legokor/INDACT_Hardware/RC_SHIELD/INDACT_baseboard.xlsx

Source: | C:\Users\Andi\Desktop\Andi\SULI\BME\Legokor\INDACT\INDACT_bb\repo\INDACT_Hardware\RC_SHIELD\INDACT_baseboard.kicad_sch
Date: | 2023-10-18 21:43
Tool: | Eeschema 7.0.7
Generator: | C:\Program Files\KiCad\7.0\bin\scripting\plugins/bom_csv_grouped_by_value.py
Component Count: | 135
Collated Components:
Item | Qty | Reference(s) | Value | DNP | Price | Link
1 | 1 | A1 | NUCLEO-F746ZG |  | None
2 | 2 | C1, C12 | 1u | 32.13 | 64.26 | https://www.hestore.hu/prod_10036059.html
3 | 2 | C2, C3 | 1.5n | 4.17 | 8.34 | https://www.hestore.hu/prod_10001406.html
4 | 5 | C4, C5, C10, C11, C14 | 100n | 29.93 | 149.65 | https://www.hestore.hu/prod_10039650.html
5 | 3 | C6, C7, C8 | 1000u | 380 | 1140 | https://www.hestore.hu/prod_10028496.html
6 | 1 | C9 | 10n | 30.04 | 30.04 | https://www.hestore.hu/prod_10024356.html
7 | 1 | C13 | 4u7 | 31.37 | 31.37 | https://www.hestore.hu/prod_10037167.html
8 | 2 | C15, C16 | 11p |  | 0 | tesó ez mi
9 | 1 | D1 | WIFI-OP | 50 | 50 | https://www.hestore.hu/prod_10025836.html
10 | 1 | D2 | 3V3_STATUS | 50 | 50 | más szín?
11 | 1 | D3 | 5V_STATUS | 50 | 50 | más szín?
12 | 1 | D4 | 24V_STATUS | 50 | 50 | más szín?
13 | 1 | J1 | P5a | 654 | 654 | https://www.hestore.hu/prod_10026484.html
14 | 1 | J2 | P4a | 387 | 387 | https://www.hestore.hu/prod_10026483.html
15 | 1 | J3 | FAN |  | 0 | sima pin, van
16 | 1 | J4 | I2C_TEMP |  | 0 | sima pin, van
17 | 1 | J5 | GPIO1 |  | 0 | sima pin, van
18 | 1 | J6 | ESTOP |  | 0 | sima pin, van
19 | 1 | J7 | DOOR_SWITCH |  | 0 | sima pin, van
20 | 1 | J8 | GPIO2 |  | 0 | sima pin, van
21 | 1 | J9 | SPI |  | 0 | sima pin, van
22 | 1 | J10 | POWER_SUPPLY | 202 | 202 | https://www.hestore.hu/prod_10042566.html
23 | 1 | J11 | R_MOT_DRV | 202 | 202 | https://www.hestore.hu/prod_10042566.html
24 | 1 | J12 | TH_MOT_DRV | 202 | 202 | https://www.hestore.hu/prod_10042566.html
25 | 1 | J13 | Z_MOT_DRV | 202 | 202 | https://www.hestore.hu/prod_10042566.html
26 | 1 | J14 | ALF_MOT_DRV | 202 | 202 | https://www.hestore.hu/prod_10042566.html
27 | 1 | J17 | PHI_MOT_DRV | 202 | 202 | https://www.hestore.hu/prod_10042566.html
28 | 1 | J25 | BET_MOT_DRV | 202 | 202 | https://www.hestore.hu/prod_10042566.html
29 | 1 | J26 | SWD |  | 0
30 | 1 | J27 | P3a | 181 | 181 | https://www.hestore.hu/prod_10031174.html
31 | 2 | Q1, Q2 | BSS123 | 43.82 | 87.64 | https://www.hestore.hu/prod_10021019.html
32 | 2 | R1, R11 | 1k | 28.47 | 56.94 | https://www.hestore.hu/prod_10023881.html
33 | 1 | R2 | 150R | 1.18 | 1.18 | https://www.hestore.hu/prod_10023929.html
34 | 4 | R3, R4, R6, R7 | 560R | 3.83 | 15.32 | https://www.hestore.hu/prod_10023915.html
35 | 1 | R5 | 1K? | 28.47 | 28.47 | https://www.hestore.hu/prod_10023881.html
36 | 2 | R8, R10 | 120R | 29.1 | 58.2 | https://www.hestore.hu/prod_10023914.html
37 | 1 | R9 | 4K7 | 3.9 | 3.9 | https://www.hestore.hu/prod_10023911.html
38 | 1 | R12 | 5k1 | 1.18 | 1.18 | https://www.hestore.hu/prod_10036539.html
39 | 28 | R13, R14, R15, R16, R20, R21, R22, R23, R24, R25, R26, R27, R28, R29, R30, R31, R32, R33, R36, R37, R38, R39, R40, R41, R42, R43, R44, R45 | 1K2 | 1.18 | 33.04 | https://www.hestore.hu/prod_10023920.html
40 | 3 | R17, R18, R19 | 100R | 28.56 | 85.68 | https://www.hestore.hu/prod_10023885.html
41 | 1 | R34 | 20k | 28.45 | 28.45 | https://www.hestore.hu/prod_10028622.html
42 | 1 | R35 | 200k | 29.58 | 29.58 | https://www.hestore.hu/prod_10001160.html
43 | 1 | RV1 | DISP_CONTRAST | 121 | 121 | https://www.hestore.hu/prod_10043614.html
44 | 1 | SW1 | SW_Push | 203 | 203 | https://www.hestore.hu/prod_10027967.html
45 | 1 | TP1 | TP_24V |  | 0 | tesztpont
46 | 1 | TP2 | TP_5V |  | 0 | tesztpont
47 | 1 | TP3 | TP_COM24 |  | 0 | tesztpont
48 | 1 | TP4 | TP_COM5 |  | 0 | tesztpont
49 | 1 | TP5 | TP_3V3 |  | 0 | tesztpont
50 | 1 | TP6 | TP_ESP01_RST |  | 0 | tesztpont
51 | 1 | TP7 | TP_ESP01_CHPD |  | 0 | tesztpont
52 | 1 | TP8 | TP_LCD_ENA |  | 0 | tesztpont
53 | 1 | TP9 | TP_LCD_Contrast |  | 0 | tesztpont
54 | 1 | TP10 | TP_SPI_NSS |  | 0 | tesztpont
55 | 1 | U1 | ESP8266-01/ESP-01 |  | 0 | van
56 | 1 | U2 | SN75LBC179AD | 1312 | 1312 | https://www.tme.eu/hu/en/details/sn75lbc179ad/rs232-422-485-interfaces-integr-circ/texas-instruments/
57 | 1 | U3 | LCD-016N002L |  | 0
58 | 31 | U4, U5, U6, U7, U8, U9, U10, U11, U12, U13, U14, U15, U16, U17, U18, U19, U20, U21, U22, U23, U24, U26, U27, U28, U29, U30, U31, U32, U33, U34, U35 | SFH6345 | 276 | 8556 | https://www.hestore.hu/prod_10034079.html
59 | 1 | U25 | STM32F030K6Tx | 566 | 566 | https://www.hestore.hu/prod_10044309.html
60 | 1 | VR1 | LM3940IMP-3.3/NOPB | 737 | 737 | https://www.hestore.hu/prod_10028511.html
61 | 1 | Y1 | 8MHz | 112 | 112 | https://www.hestore.hu/prod_10030976.html
 |  |  |  |  | 16296.24
 |  |  |  | +áfa | 20696.2248
