legokor/INDACT_Hardware/RC_SHIELD/INDACT_baseboard_pcb.pdf

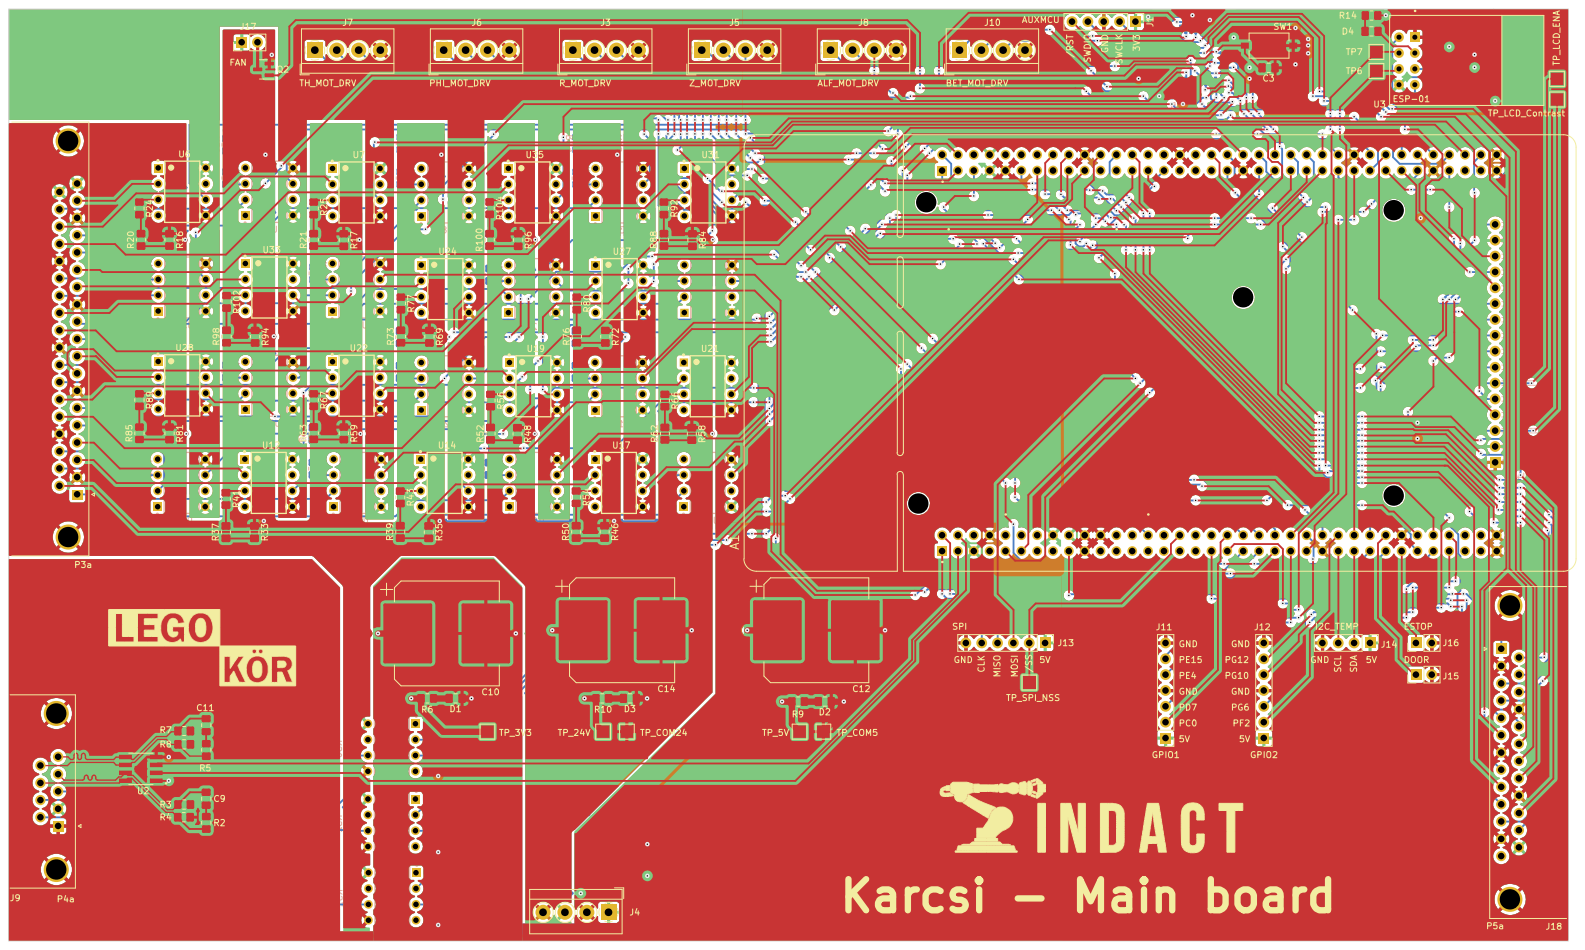
[picture p1: page 1]
