legokor/INDACT_Hardware/RC_SHIELD/bb_mcu2.kicad_sch

## KiCad design RC_SHIELD/bb_mcu2.kicad_sch (2024-06-19)

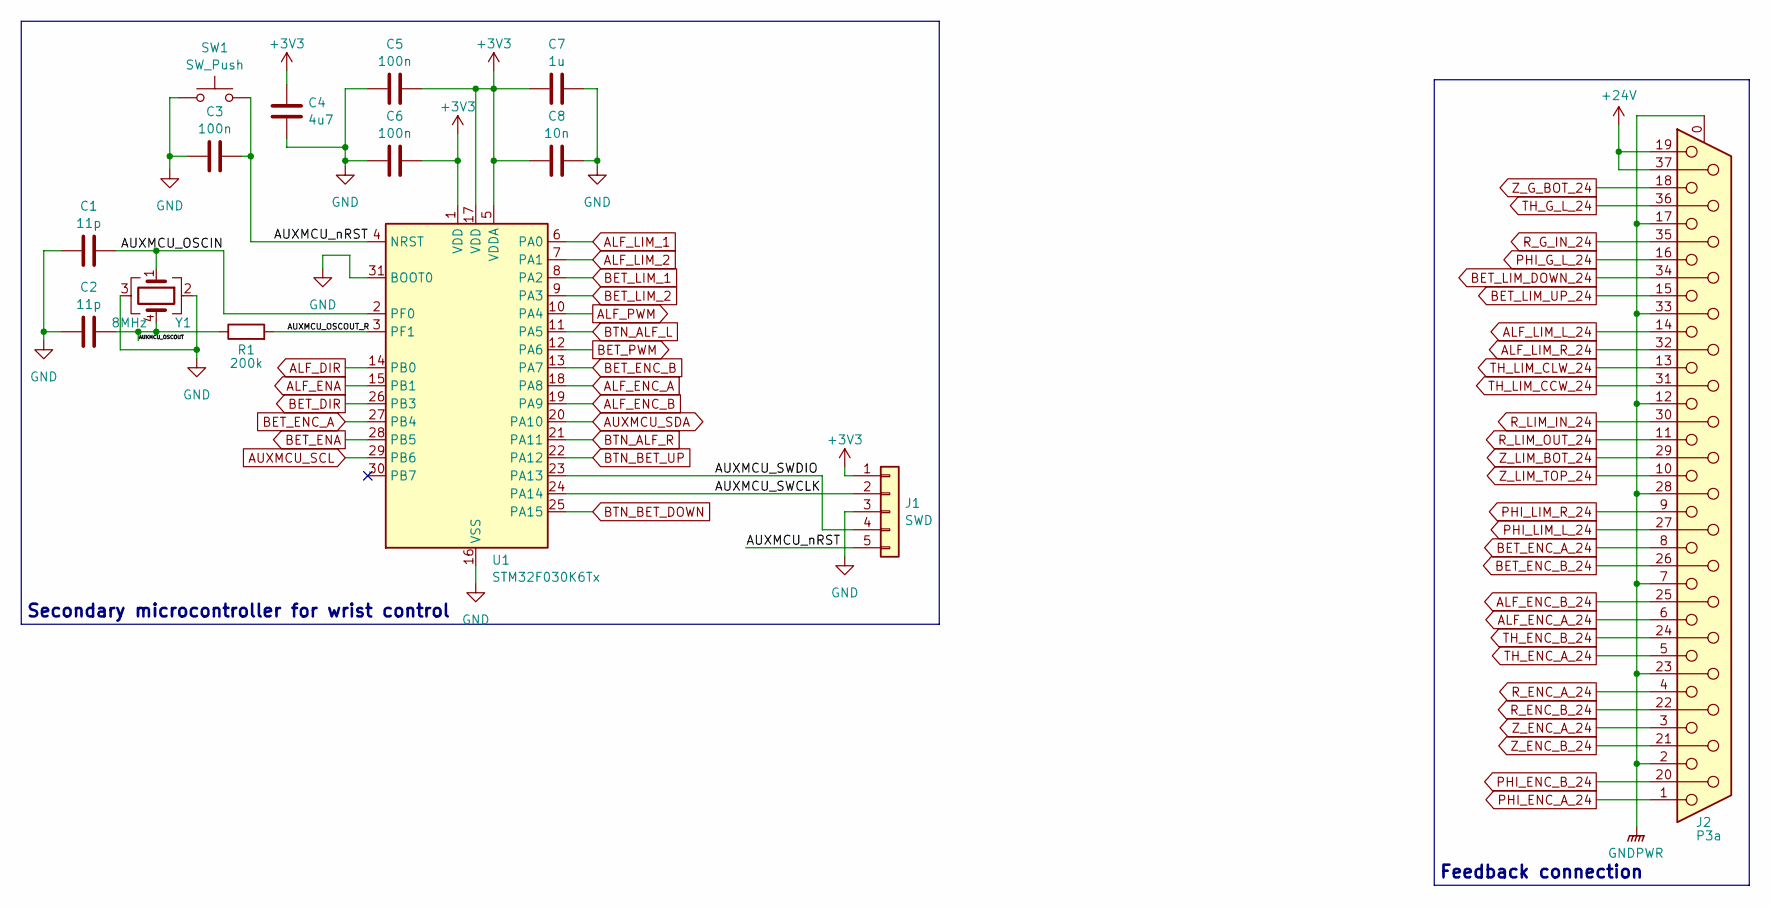
[picture p9: schematic bb_mcu2.kicad_sch]

Parts:
C1, C2: 11p; C_0805_2012Metric_Pad1.18x1.45mm_HandSolder
C3, C5, C6: 100n; C_0805_2012Metric_Pad1.18x1.45mm_HandSolder
C4: 4u7; C_0805_2012Metric_Pad1.18x1.45mm_HandSolder
C7: 1u; C_0805_2012Metric_Pad1.18x1.45mm_HandSolder
C8: 10n; C_0805_2012Metric_Pad1.18x1.45mm_HandSolder
J1: SWD; PinHeader_1x05_P2.54mm_Vertical
J2: P3a; DSUB-37_Female_Horizontal_P2.77x2.84mm_EdgePinOffset7.70mm_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
R1: 200k; R_0805_2012Metric_Pad1.20x1.40mm_HandSolder
SW1: SW_Push; SW_Tactile_SPST_NO_Straight_CK_PTS636Sx25SMTRLFS
U1: STM32F030K6Tx; LQFP-32_7x7mm_P0.8mm
Y1: 8MHz; Crystal_SMD_3225-4Pin_3.2x2.5mm_HandSoldering

Connections:
+3V3: C4.1, C5.2, C6.2, C7.1, C8.1, J1.1, U1.1 (VDD), U1.5 (VDDA), U1.17 (VDD)
+24V: J2.19, J2.37
ALF_DIR: U1.14 (PB0)
ALF_ENA: U1.15 (PB1)
ALF_ENC_A: U1.18 (PA8)
ALF_ENC_A_24: J2.6
ALF_ENC_B: U1.19 (PA9)
ALF_ENC_B_24: J2.25
ALF_LIM_1: U1.6 (PA0)
ALF_LIM_2: U1.7 (PA1)
ALF_LIM_L_24: J2.14
ALF_LIM_R_24: J2.32
ALF_PWM: U1.10 (PA4)
AUXMCU_OSCIN: C1.2, U1.2 (PF0), Y1.1
AUXMCU_OSCOUT: C2.2, R1.1, Y1.4
AUXMCU_OSCOUT_R: R1.2, U1.3 (PF1)
AUXMCU_SCL: U1.29 (PB6)
AUXMCU_SDA: U1.20 (PA10)
AUXMCU_SWCLK: J1.2, U1.24 (PA14)
AUXMCU_SWDIO: J1.4, U1.23 (PA13)
AUXMCU_nRST: C3.2, J1.5, SW1.2, U1.4 (NRST)
BET_DIR: U1.26 (PB3)
BET_ENA: U1.28 (PB5)
BET_ENC_A: U1.27 (PB4)
BET_ENC_A_24: J2.8
BET_ENC_B: U1.13 (PA7)
BET_ENC_B_24: J2.26
BET_LIM_1: U1.8 (PA2)
BET_LIM_2: U1.9 (PA3)
BET_LIM_DOWN_24: J2.34
BET_LIM_UP_24: J2.15
BET_PWM: U1.12 (PA6)
BTN_ALF_L: U1.11 (PA5)
BTN_ALF_R: U1.21 (PA11)
BTN_BET_DOWN: U1.25 (PA15)
BTN_BET_UP: U1.22 (PA12)
GND: C1.1, C2.1, C3.1, C4.2, C5.1, C6.1, C7.2, C8.2, J1.3, SW1.1, U1.16 (VSS), U1.31 (BOOT0), U1.32 (VSS), Y1.2, Y1.3
GNDPWR: J2.0 (PAD), J2.2, J2.7, J2.12, J2.17, J2.23, J2.28, J2.33
PHI_ENC_A_24: J2.1
PHI_ENC_B_24: J2.20
PHI_G_L_24: J2.16
PHI_LIM_L_24: J2.27
PHI_LIM_R_24: J2.9
R_ENC_A_24: J2.4
R_ENC_B_24: J2.22
R_G_IN_24: J2.35
R_LIM_IN_24: J2.30
R_LIM_OUT_24: J2.11
TH_ENC_A_24: J2.5
TH_ENC_B_24: J2.24
TH_G_L_24: J2.36
TH_LIM_CCW_24: J2.31
TH_LIM_CLW_24: J2.13
Z_ENC_A_24: J2.3
Z_ENC_B_24: J2.21
Z_G_BOT_24: J2.18
Z_LIM_BOT_24: J2.29
Z_LIM_TOP_24: J2.10

Notes on the sheet:
Secondary microcontroller for wrist control
Feedback connection
