legokor/INDACT_Hardware/RC_SHIELD/bb_optocouplers2.kicad_sch

## KiCad design RC_SHIELD/bb_optocouplers2.kicad_sch (2024-06-19)

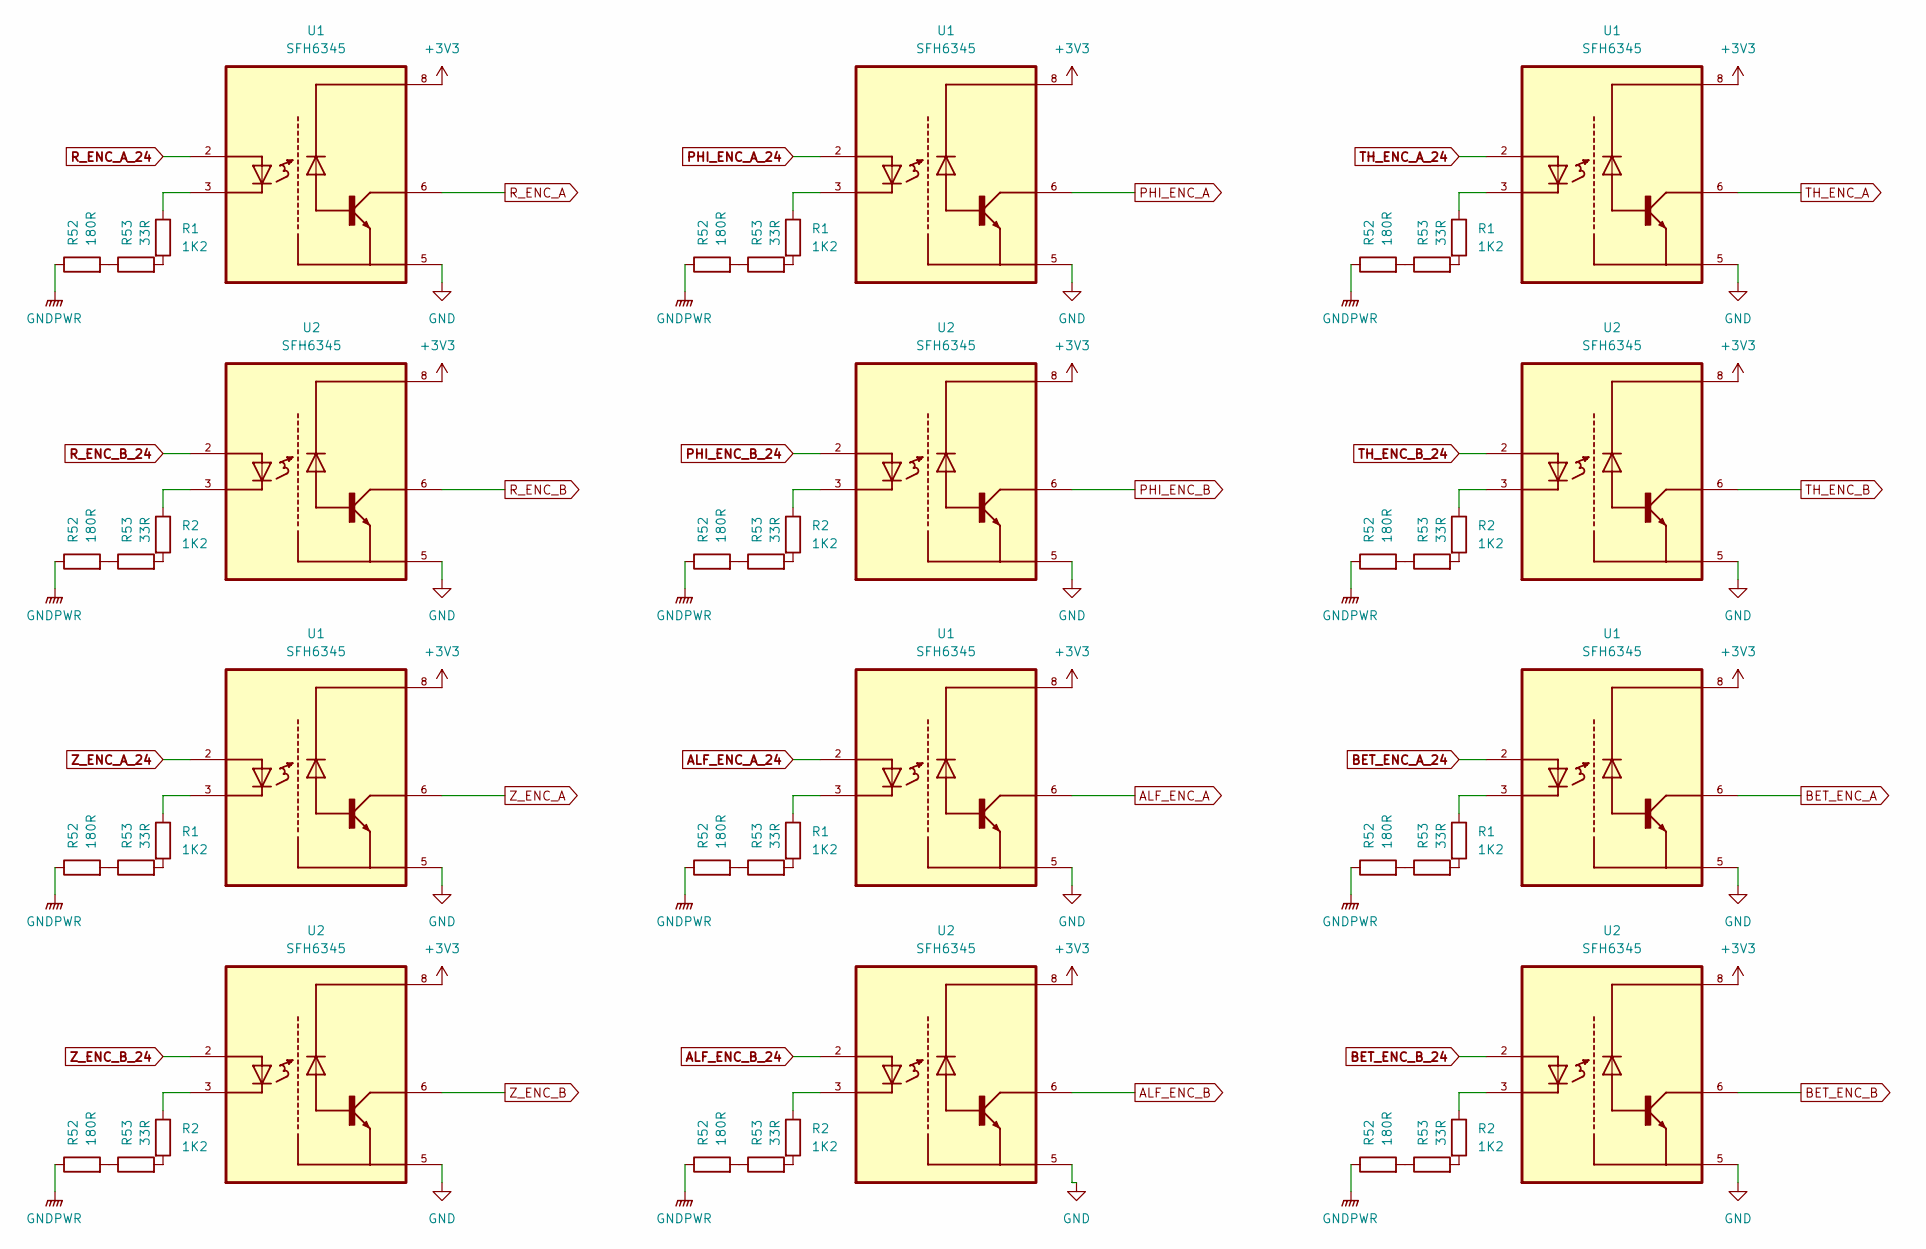
[picture p10: schematic bb_optocouplers2.kicad_sch]

Parts:
R1, R2: 1K2; R_0805_2012Metric_Pad1.20x1.40mm_HandSolder
R52: 180R; R_0805_2012Metric_Pad1.20x1.40mm_HandSolder
R53: 33R; R_0805_2012Metric_Pad1.20x1.40mm_HandSolder
U1, U2: SFH6345; DIP762W50P254L977H451Q8

Connections:
+3V3: U1.8, U2.8
ALF_ENC_A: U1.6
ALF_ENC_A_24: U1.2
ALF_ENC_B: U2.6
ALF_ENC_B_24: U2.2
BET_ENC_A: U1.6
BET_ENC_A_24: U1.2
BET_ENC_B: U2.6
BET_ENC_B_24: U2.2
GND: U1.5, U2.5
GNDPWR: R52.1
unnamed: R1.1, U1.3
unnamed: R1.2, R53.2
unnamed: R2.1, U2.3
unnamed: R2.2, R53.2
unnamed: R52.2, R53.1
PHI_ENC_A: U1.6
PHI_ENC_A_24: U1.2
PHI_ENC_B: U2.6
PHI_ENC_B_24: U2.2
R_ENC_A: U1.6
R_ENC_A_24: U1.2
R_ENC_B: U2.6
R_ENC_B_24: U2.2
TH_ENC_A: U1.6
TH_ENC_A_24: U1.2
TH_ENC_B: U2.6
TH_ENC_B_24: U2.2
Z_ENC_A: U1.6
Z_ENC_A_24: U1.2
Z_ENC_B: U2.6
Z_ENC_B_24: U2.2
