legokor/INDACT_Hardware/RC_SHIELD/bb_optocouplers.kicad_sch

## KiCad design RC_SHIELD/bb_optocouplers.kicad_sch (2024-06-19)

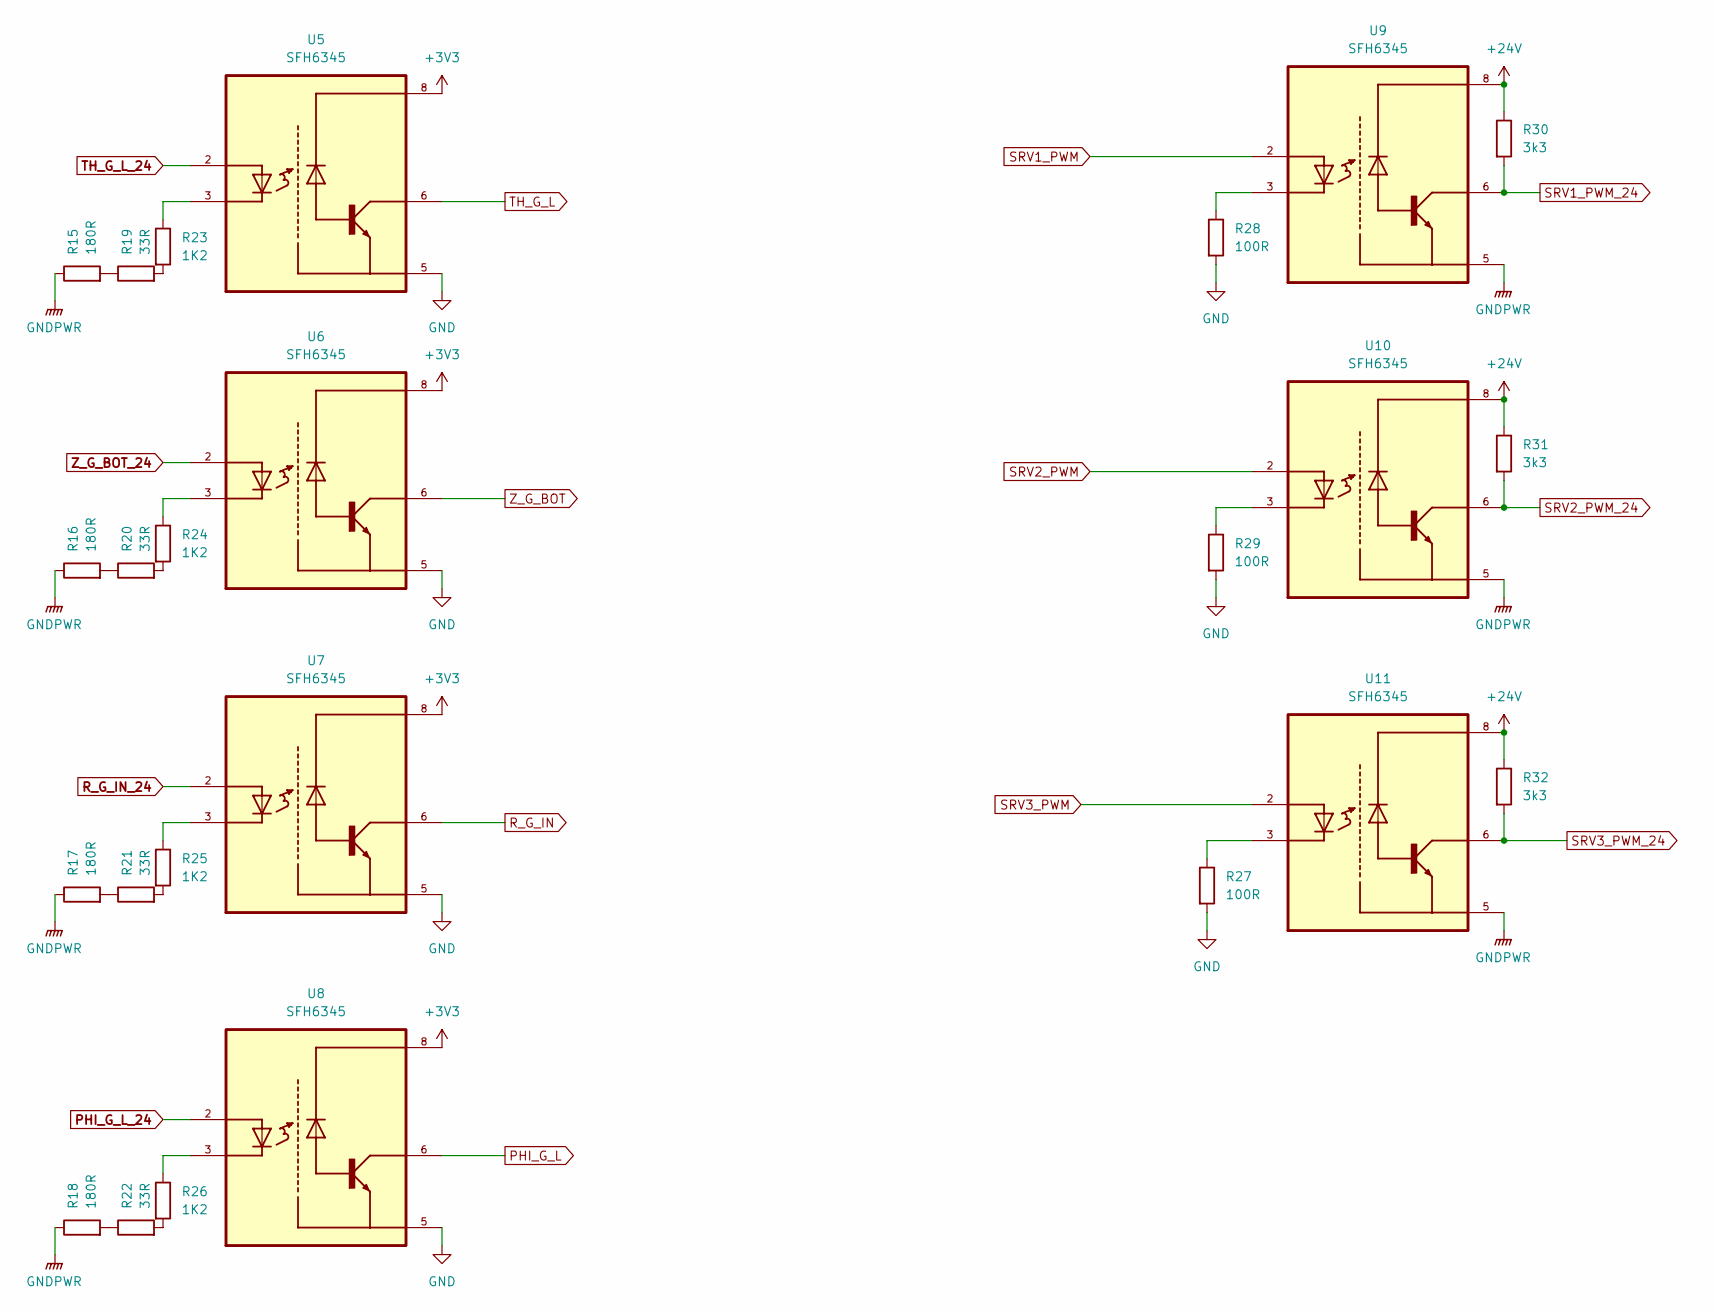
[picture p11: schematic bb_optocouplers.kicad_sch]

Parts:
R15, R16, R17, R18: 180R; R_0805_2012Metric_Pad1.20x1.40mm_HandSolder
R19, R20, R21, R22: 33R; R_0805_2012Metric_Pad1.20x1.40mm_HandSolder
R23, R24, R25, R26: 1K2; R_0805_2012Metric_Pad1.20x1.40mm_HandSolder
R27, R28, R29: 100R; R_0805_2012Metric_Pad1.20x1.40mm_HandSolder
R30, R31, R32: 3k3; R_0805_2012Metric_Pad1.20x1.40mm_HandSolder
U5, U6, U7, U8, U9, U10, U11: SFH6345; DIP762W50P254L977H451Q8

Connections:
+3V3: U5.8, U6.8, U7.8, U8.8
+24V: R30.1, R31.1, R32.1, U9.8, U10.8, U11.8
GND: R27.2, R28.2, R29.2, U5.5, U6.5, U7.5, U8.5
GNDPWR: R15.1, R16.1, R17.1, R18.1, U9.5, U10.5, U11.5
unnamed: R15.2, R19.1
unnamed: R16.2, R20.1
unnamed: R17.2, R21.1
unnamed: R18.2, R22.1
unnamed: R19.2, R23.2
unnamed: R20.2, R24.2
unnamed: R21.2, R25.2
unnamed: R22.2, R26.2
unnamed: R23.1, U5.3
unnamed: R24.1, U6.3
unnamed: R25.1, U7.3
unnamed: R26.1, U8.3
unnamed: R27.1, U11.3
unnamed: R28.1, U9.3
unnamed: R29.1, U10.3
PHI_G_L: U8.6
PHI_G_L_24: U8.2
R_G_IN: U7.6
R_G_IN_24: U7.2
SRV1_PWM: U9.2
SRV1_PWM_24: R30.2, U9.6
SRV2_PWM: U10.2
SRV2_PWM_24: R31.2, U10.6
SRV3_PWM: U11.2
SRV3_PWM_24: R32.2, U11.6
TH_G_L: U5.6
TH_G_L_24: U5.2
Z_G_BOT: U6.6
Z_G_BOT_24: U6.2
