legokor/INDACT_Hardware/RC_SHIELD/bb_periferia.kicad_sch

## KiCad design RC_SHIELD/bb_periferia.kicad_sch (2024-06-19)

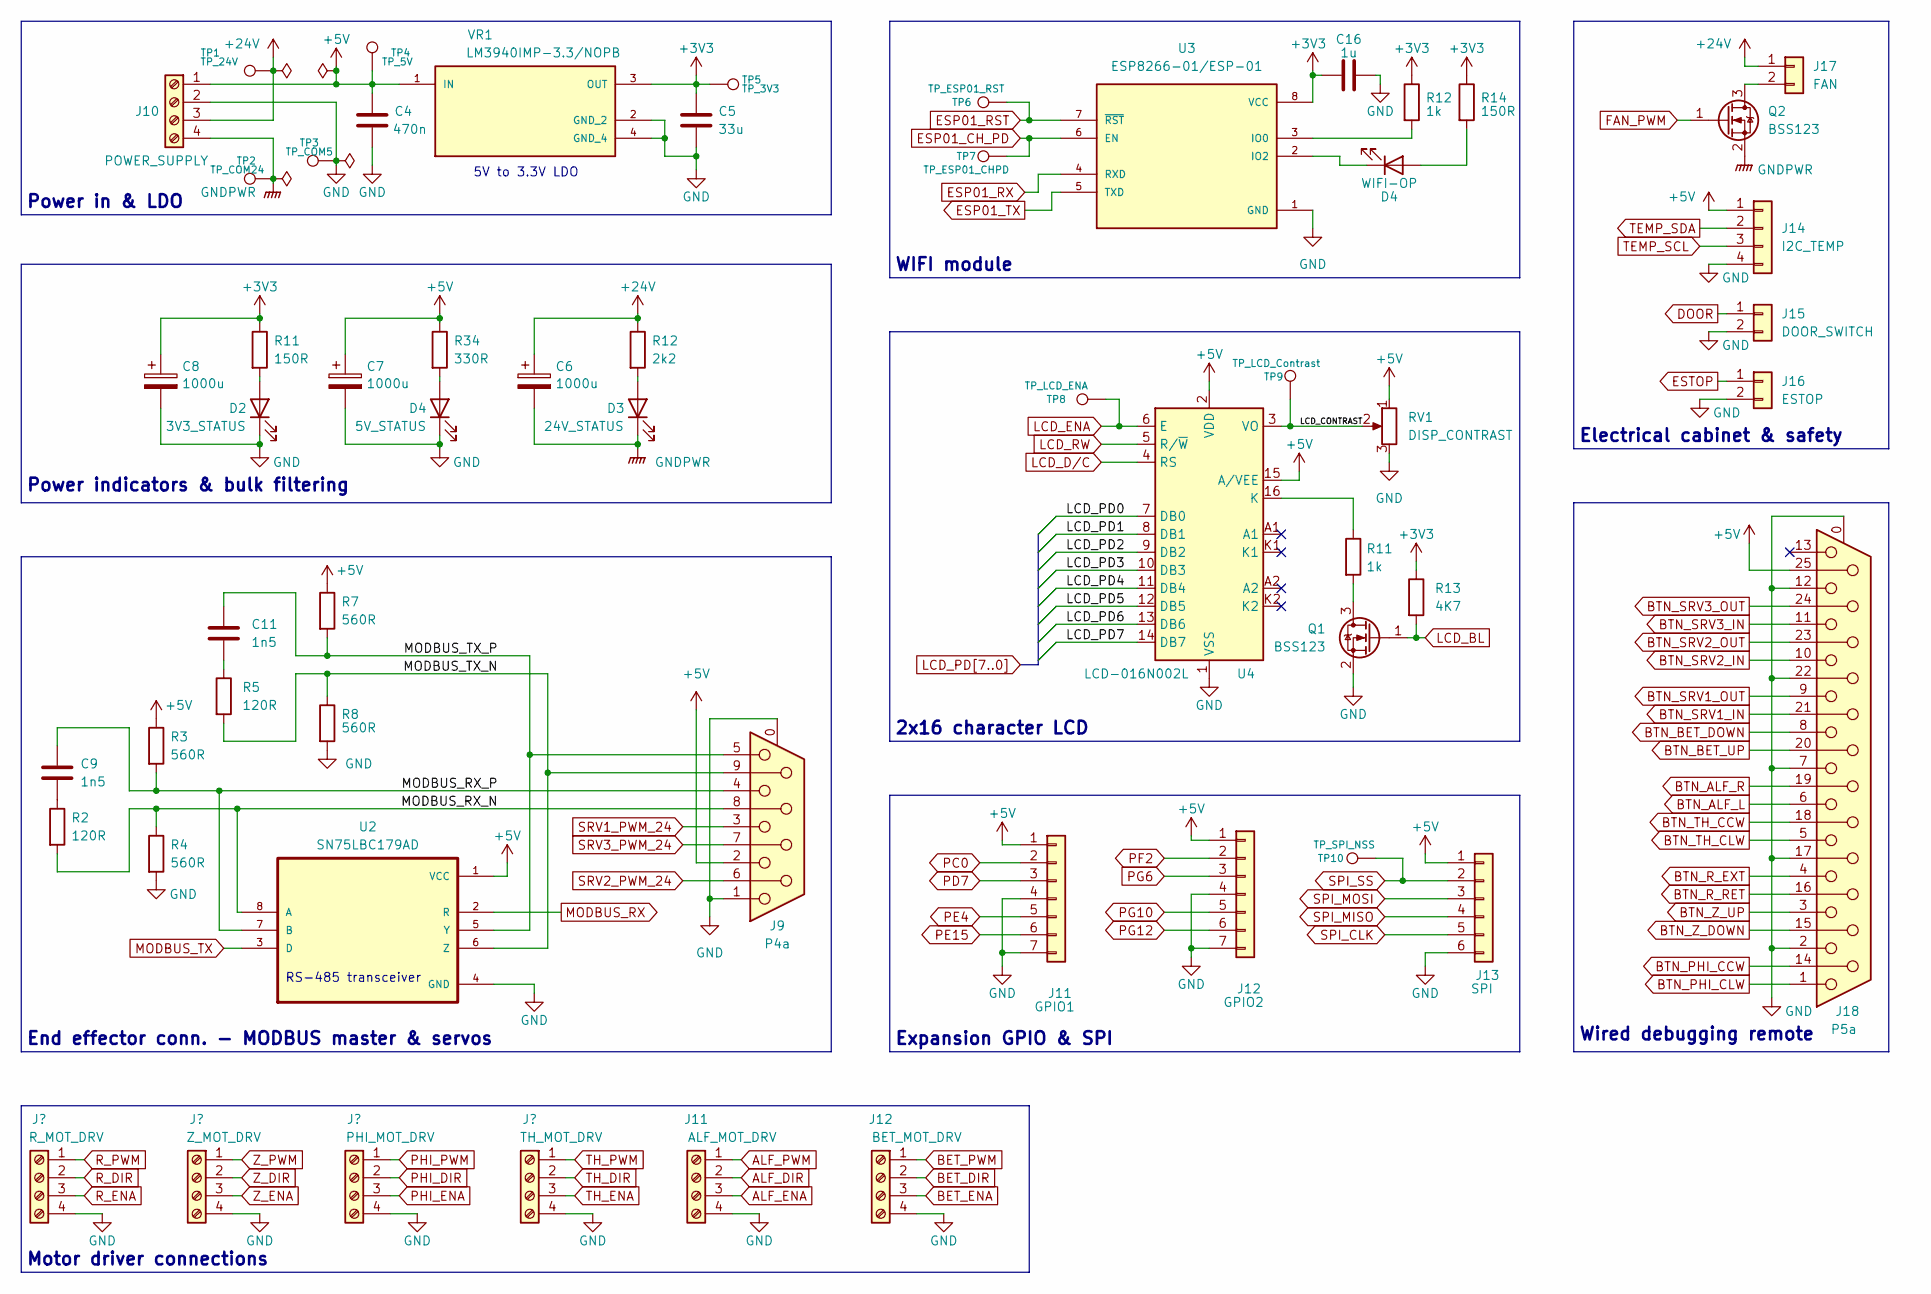
[picture p12: schematic bb_periferia.kicad_sch]

Parts:
C4: 470n; C_0805_2012Metric_Pad1.18x1.45mm_HandSolder
C5: 33u; C_0805_2012Metric_Pad1.18x1.45mm_HandSolder
C6, C7, C8: 1000u; CP_Elec_16x22
C9, C11: 1n5; C_0805_2012Metric_Pad1.18x1.45mm_HandSolder
C16: 1u; C_0805_2012Metric_Pad1.18x1.45mm_HandSolder
D2: 3V3_STATUS; LED_0805_2012Metric_Pad1.15x1.40mm_HandSolder
D3: 24V_STATUS; LED_0805_2012Metric_Pad1.15x1.40mm_HandSolder
D4: 5V_STATUS; LED_0805_2012Metric_Pad1.15x1.40mm_HandSolder
J3: R_MOT_DRV; TerminalBlock_4Ucon_1x04_P3.50mm_Horizontal
J5: Z_MOT_DRV; TerminalBlock_4Ucon_1x04_P3.50mm_Horizontal
J6: PHI_MOT_DRV; TerminalBlock_4Ucon_1x04_P3.50mm_Horizontal
J7: TH_MOT_DRV; TerminalBlock_4Ucon_1x04_P3.50mm_Horizontal
J9: P4a; DSUB-9_Female_Horizontal_P2.77x2.84mm_EdgePinOffset4.94mm_H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; PARTREV E
J10: POWER_SUPPLY; TerminalBlock_4Ucon_1x04_P3.50mm_Horizontal
J11: GPIO1; PinHeader_1x07_P2.54mm_Vertical
J12: BET_MOT_DRV; TerminalBlock_4Ucon_1x04_P3.50mm_Horizontal
J13: SPI; PinHeader_1x06_P2.54mm_Vertical
J14: I2C_TEMP; PinHeader_1x04_P2.54mm_Vertical
J15: DOOR_SWITCH; PinHeader_1x02_P2.54mm_Vertical
J16: ESTOP; PinHeader_1x02_P2.54mm_Vertical
J17: FAN; PinHeader_1x02_P2.54mm_Vertical
J18: P5a; DSUB-25_Female_Horizontal_P2.77x2.84mm_EdgePinOffset7.70mm_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
Q1, Q2: BSS123; SOT-23
R2, R5: 120R; R_0805_2012Metric_Pad1.20x1.40mm_HandSolder
R3, R4, R7, R8: 560R; R_0805_2012Metric_Pad1.20x1.40mm_HandSolder
R11: 1k; R_0805_2012Metric_Pad1.20x1.40mm_HandSolder
R12: 2k2; R_0805_2012Metric_Pad1.20x1.40mm_HandSolder
R13: 4K7; R_0805_2012Metric_Pad1.20x1.40mm_HandSolder
R14: 150R; R_0805_2012Metric_Pad1.20x1.40mm_HandSolder
R34: 330R; R_0805_2012Metric_Pad1.20x1.40mm_HandSolder
RV1: DISP_CONTRAST; Potentiometer_Vishay_TS53YJ_Vertical
TP1: TP_24V; TestPoint_Pad_2.0x2.0mm
TP2: TP_COM24; TestPoint_Pad_2.0x2.0mm
TP3: TP_COM5; TestPoint_Pad_2.0x2.0mm
TP4: TP_5V; TestPoint_Pad_2.0x2.0mm
TP5: TP_3V3; TestPoint_Pad_2.0x2.0mm
TP6: TP_ESP01_RST; TestPoint_Pad_2.0x2.0mm
TP7: TP_ESP01_CHPD; TestPoint_Pad_2.0x2.0mm
TP8: TP_LCD_ENA; TestPoint_Pad_2.0x2.0mm
TP9: TP_LCD_Contrast; TestPoint_Pad_2.0x2.0mm
TP10: TP_SPI_NSS; TestPoint_Pad_2.0x2.0mm
U2: SN75LBC179AD; SOIC127P599X175-8N
U3: ESP8266-01/ESP-01; XCVR_ESP8266-01_ESP-01; PARTREV V1.2
U4: LCD-016N002L; PinHeader_1x16_P2.54mm_Horizontal
VR1: LM3940IMP-3.3/NOPB; VREG_LM3940IMP-3.3_NOPB; PARTREV G

Connections:
+3V3: C5.1, C8.1, C16.1, R11.1, R12.1, R13.1, R14.1, TP5.1, U3.8 (VCC), VR1.3 (OUT)
+5V: C4.1, C7.1, J9.2, J10.1, J11.1, J12.1, J13.1, J14.1, J18.25, R3.1, R7.1, R34.1, RV1.1, TP4.1, U2.1 (VCC), U4.2 (VDD), U4.15 (A/VEE), VR1.1 (IN)
+24V: C6.1, J10.3, J17.1, R12.1, TP1.1
ALF_DIR: J11.2
ALF_ENA: J11.3
ALF_PWM: J11.1
BET_DIR: J12.2
BET_ENA: J12.3
BET_PWM: J12.1
BTN_ALF_L: J18.6
BTN_ALF_R: J18.19
BTN_BET_DOWN: J18.8
BTN_BET_UP: J18.20
BTN_PHI_CCW: J18.14
BTN_PHI_CLW: J18.1
BTN_R_EXT: J18.4
BTN_R_RET: J18.16
BTN_SRV1_IN: J18.21
BTN_SRV1_OUT: J18.9
BTN_SRV2_IN: J18.10
BTN_SRV2_OUT: J18.23
BTN_SRV3_IN: J18.11
BTN_SRV3_OUT: J18.24
BTN_TH_CCW: J18.18
BTN_TH_CLW: J18.5
BTN_Z_DOWN: J18.15
BTN_Z_UP: J18.3
DOOR: J15.1
ESP01_CH_PD: TP7.1, U3.6 (EN)
ESP01_RST: TP6.1, U3.7 (~RST)
ESP01_RX: U3.4 (RXD)
ESP01_TX: U3.5 (TXD)
ESTOP: J16.1
FAN_PWM: Q2.1 (G)
GND: C4.2, C5.2, C7.2, C8.2, C16.2, D2.1 (K), D4.1 (K), J3.4, J5.4, J6.4, J7.4, J9.0 (PAD), J9.1, J10.2, J11.4, J11.7, J12.4, J12.7, J13.6, J14.4, J15.2, J16.2, J18.0 (PAD), J18.2, J18.7, J18.12, J18.17, J18.22, Q1.2 (S), R4.2, R8.2, RV1.3, TP3.1, U2.4 (GND), U3.1 (GND), U4.1 (VSS), VR1.2 (GND_2), VR1.4 (GND_4)
GNDPWR: C6.2, D3.1 (K), J10.4, Q2.2 (S), TP2.1
LCD_BL: Q1.1 (G), R13.2
LCD_CONTRAST: RV1.2, TP9.1, U4.3 (VO)
LCD_D/C: U4.4 (RS)
LCD_ENA: TP8.1, U4.6 (E)
LCD_PD0: U4.7 (DB0)
LCD_PD1: U4.8 (DB1)
LCD_PD2: U4.9 (DB2)
LCD_PD3: U4.10 (DB3)
LCD_PD4: U4.11 (DB4)
LCD_PD5: U4.12 (DB5)
LCD_PD6: U4.13 (DB6)
LCD_PD7: U4.14 (DB7)
LCD_RW: U4.5 (R/~W)
MODBUS_RX: U2.2 (R)
MODBUS_RX_N: J9.8, R2.2, R4.1, U2.8 (A)
MODBUS_RX_P: C9.1, J9.4, R3.2, U2.7 (B)
MODBUS_TX: U2.3 (D)
MODBUS_TX_N: J9.9, R5.2, R8.1, U2.6 (Z)
MODBUS_TX_P: C11.1, J9.5, R7.2, U2.5 (Y)
unnamed: C9.2, R2.1
unnamed: C11.2, R5.1
unnamed: D2.2 (A), R11.2
unnamed: D3.2 (A), R12.2
unnamed: D4.1 (K), U3.2 (IO2)
unnamed: D4.2 (A), R14.2, R34.2
unnamed: J17.2, Q2.3 (D)
unnamed: Q1.3 (D), R11.2
unnamed: R11.1, U4.16 (K)
unnamed: R12.2, U3.3 (IO0)
PC0: J11.2
PD7: J11.3
PE4: J11.5
PE15: J11.6
PF2: J12.2
PG6: J12.3
PG10: J12.5
PG12: J12.6
PHI_DIR: J6.2
PHI_ENA: J6.3
PHI_PWM: J6.1
R_DIR: J3.2
R_ENA: J3.3
R_PWM: J3.1
SPI_CLK: J13.5
SPI_MISO: J13.4
SPI_MOSI: J13.3
SPI_SS: J13.2, TP10.1
SRV1_PWM_24: J9.3
SRV2_PWM_24: J9.6
SRV3_PWM_24: J9.7
TEMP_SCL: J14.3
TEMP_SDA: J14.2
TH_DIR: J7.2
TH_ENA: J7.3
TH_PWM: J7.1
Z_DIR: J5.2
Z_ENA: J5.3
Z_PWM: J5.1

Notes on the sheet:
Power indicators & bulk filtering
Electrical cabinet & safety
5V to 3.3V LDO
WIFI module
2x16 character LCD
Wired debugging remote
RS-485 transceiver
End effector conn. - MODBUS master & servos
Power in & LDO
Expansion GPIO & SPI
Motor driver connections
