legokor/INDACT_Hardware/(commit log)

2023-03-19 Added baseboard schematic documents
    Created in Altium Designer v23.2.1
    [INDACT_baseboard.PrjPcb, bb_Nucleo.SchDoc, bb_optocouplers.SchDoc, bb_optocouplers2.SchDoc, bb_optocouplers3.SchDoc, bb_periferia.SchDoc, bb_power_motdrvs.SchDoc]
2023-03-26 Fixes after first review
    [INDACT_baseboard.PrjPcb, bb_Nucleo.SchDoc, bb_optocouplers.SchDoc, bb_optocouplers2.SchDoc, bb_optocouplers3.SchDoc, bb_periferia.SchDoc, bb_power_motdrvs.SchDoc]
2023-09-24 Deleted altium files
    Switching to KiCad
    [INDACT_baseboard.PrjPcb, bb_Nucleo.SchDoc, bb_optocouplers.SchDoc, bb_optocouplers2.SchDoc, bb_optocouplers3.SchDoc, bb_periferia.SchDoc, bb_power_motdrvs.SchDoc]
2023-09-24 Added KiCad files
    Switching project from Altium to KiCad
    [INDACT_baseboard.kicad_pcb, INDACT_baseboard.kicad_sch, bb_optocouplers.kicad_sch, bb_optocouplers2.kicad_sch, bb_optocouplers3.kicad_sch, bb_periferia.kicad_sch, bb_power_motdrvs.kicad_sch]
2023-10-08 added secondary MCU to schematic and made it more consistent
    [INDACT_baseboard.kicad_sch, bb_mcu2.kicad_sch, bb_optocouplers.kicad_sch, bb_optocouplers2.kicad_sch, bb_optocouplers3.kicad_sch, bb_periferia.kicad_sch, bb_power_motdrvs.kicad_sch, nucleo.kicad_sch]
2023-10-12 Added testpoints
    [bb_periferia.kicad_sch]
2023-10-25 footprints assigned
    [INDACT_baseboard.csv, INDACT_baseboard.kicad_pcb, INDACT_baseboard.xlsx, bb_mcu2.kicad_sch, bb_optocouplers.kicad_sch, bb_optocouplers2.kicad_sch, bb_optocouplers3.kicad_sch, bb_periferia.kicad_sch]
2023-11-18 Fixed typos and names in schematic, changed optocoupler resistors; added .gitgnore file
    [bb_mcu2.kicad_sch, bb_optocouplers.kicad_sch, bb_optocouplers2.kicad_sch, bb_optocouplers3.kicad_sch, bb_periferia.kicad_sch, nucleo.kicad_sch]
2023-11-19 created pcb layout, review needed
    [bb_periferia.kicad_sch]
2023-11-22 final fixes
    [bb_periferia.kicad_sch]
2023-11-22 added mounting holes
2023-11-26 [SCH] updated power indicator LED resistor values and tidied up page 3
    [bb_periferia.kicad_sch]
2023-11-26 [SCH] reorganized optocouplers and tidied up page 2
    [INDACT_baseboard.kicad_sch, bb_optocouplers1.kicad_sch, bb_optocouplers2.kicad_sch, bb_optocouplers3.kicad_sch, nucleo.kicad_sch]
2023-11-26 [SCH] added "exclude from BOM" signs
    [INDACT_baseboard.kicad_sch, bb_mcu2.kicad_sch, bb_optocouplers3.kicad_sch, bb_periferia.kicad_sch, nucleo.kicad_sch]
2023-11-26 [SCH] reannotated entire schematic so PCBnew wont complain
    [bb_mcu2.kicad_sch, bb_optocouplers1.kicad_sch, bb_optocouplers2.kicad_sch, bb_optocouplers3.kicad_sch, bb_periferia.kicad_sch, nucleo.kicad_sch]
2023-11-26 Revert "[SCH] reannotated entire schematic so PCBnew wont complain"
    This reverts commit df148950bb8496d2d5af5a937770664cb0004a0d.
    [bb_mcu2.kicad_sch, bb_optocouplers1.kicad_sch, bb_optocouplers2.kicad_sch, bb_optocouplers3.kicad_sch, bb_periferia.kicad_sch, nucleo.kicad_sch]
2023-11-26 Revert "[SCH] reorganized optocouplers and tidied up page 2"
    This reverts commit 005640e4067293c5014d1b79d289b32d97da3ff9.
    [INDACT_baseboard.kicad_sch, bb_optocouplers.kicad_sch, bb_optocouplers1.kicad_sch, bb_optocouplers2.kicad_sch, bb_optocouplers3.kicad_sch, nucleo.kicad_sch]
2023-11-26 [SCH] fixed Nucleo papercuts
    [INDACT_baseboard.kicad_sch, bb_mcu2.kicad_sch, bb_optocouplers.kicad_sch, bb_optocouplers3.kicad_sch, nucleo.kicad_sch]
2023-11-27 [PCB] cleaned up some tracks and added stitching vias
